elvisplantak/SynMachine/hardware/README.md

# Hardware design documentation

This directory is reserved for future mechanical drawings, CAD, wiring diagrams
and component documentation. No new design file or hardware capability is implied
by this placeholder. Current physical facts remain canonical in
[firmware/HARDWARE_CONFIRMATIONS.md](../firmware/HARDWARE_CONFIRMATIONS.md).
Any future hardware-design license will be selected explicitly and may differ
from the software license.
