elvisplantak/SynMachine/docs/LABFORGE_DEVELOPMENT_GOVERNANCE.md

# SynMachine Development Governance and Independent Review Workflow

This document is the authoritative and overriding source for the current
LabForge development workflow, agent roles, approval boundaries, and review
process. If it conflicts with older workflow instructions, this document takes
precedence. Other project documents remain useful as historical context and
technical information, but may contain outdated implementation status or
superseded workflow decisions.

## Roles

- Codex is the primary implementation agent and leads development.
- ChatGPT is the independent architectural, safety, protocol, recovery, and
  integration reviewer.
- The user owns product intent, unconfirmed physical facts, meaningful competing
  product choices, risky actions, and physical-execution authorization.

## Autonomous development scope

The user has granted Codex standing authorization to inspect, design,
implement, test, build, diagnose, self-review, update implementation-status
documentation, create feature branches, stage, create local commits, and push
Codex feature branches within the currently approved development phase.

Codex may autonomously complete all safe, non-blocked software milestones
inside that approved phase. It should not stop for review or approval after
every file edit, test, correction, commit, or other mechanical step.

User clarification on 2026-09-28: maximize independent progress and ask for
permission only when necessary under the actual approval boundaries below.
Codex decides whether to continue or request independent review; consolidate
review after substantial cohesive progress instead of reviewing each small
milestone. When review is warranted, provide the user a copy-paste handoff in
the conversation, not only a link to a document. This does not authorize physical
execution or other explicitly gated actions.

User clarification on 2026-09-30: independent reviewer suggestions are advisory,
not instructions to implement automatically. Prefer a coherent integrated slice
and consolidated review over repeated small checkpoints. Codex independently
chooses technically appropriate changes and remains responsible for delivery.

User clarification on 2026-10-01: use the independent reviewer much less often.
Continue safe implementation across small substeps and consolidate review at a
substantial integration or safety boundary, rather than after each checkpoint.

User clarification on 2026-10-03: while the reviewer is unavailable, continue the
approved software integration autonomously. Consolidate independent review at the
end of the complete connected task; no intermediate reviewer response is required.
Physical execution, production activation and main merges remain gated.

Before entering a materially different or riskier phase, Codex recommends the
next phase and obtains concise user approval. In particular, completing
no-motion protocol foundations does not authorize actuator implementation,
firmware upload, or physical execution.

## Normal workflow

Within the approved phase, Codex normally:

1. inspects canonical context, code, tests, and Git state;
2. protects unrelated work and isolates overlapping work in another branch or
   worktree when needed;
3. defines and implements the smallest cohesive slice;
4. adds or updates tests;
5. runs focused and complete relevant verification;
6. reviews the complete local diff and resource impact;
7. updates implementation-status documentation;
8. commits and pushes the verified feature branch; and
9. provides a concise checkpoint report for the user, plus an independent-
   reviewer handoff only when Codex identifies a meaningful review gate.

A dirty tree is not an automatic stop. Existing work must be inspected and
preserved. Stop only when safe isolation is impossible or changes overlap the
authorized scope in a way that cannot be resolved safely.

## Actions requiring explicit user approval

Codex must ask before:

- merging or directly modifying `main`;
- deleting branches or rewriting shared history;
- destructive or difficult-to-recover operations;
- creating or changing a PR when its publication or final scope needs a user
  decision;
- clearing, repairing, migrating, or provisioning EEPROM;
- uploading firmware or opening a Serial monitor against real hardware;
- homing or moving any physical actuator;
- running no-load, liquid, or other physical tests;
- selecting unconfirmed wiring, pins, switch contact mode, electrical polarity,
  motor/valve direction, angles, steps, calibration, or safe fluidic routes; or
- resolving a meaningful product or safety choice with competing alternatives.

Software authorization never implies physical authorization.

## Canonical sources and repository ownership

- `docs/LABFORGE_CONTEXT.md` is canonical for system-level context.
- `docs/LABFORGE_CURRENT_STATE.md` is canonical for the concise current development
  checkpoint.
- Firmware `firmware/HARDWARE_CONFIRMATIONS.md` is canonical for confirmed physical
  hardware facts.
- Firmware `firmware/docs/LABFORGE_SERIAL_PROTOCOL_V1.md` is canonical for software
  communication semantics.
- Current code and passing tests establish actual implementation state.

Frontend owns visualization and user interaction. Backend owns lifecycle,
planning, durable intent, route decisions, recovery policy, and orchestration.
Firmware owns pins, motor direction, stepping, homing, debounce, low-level
timeouts, and device execution. Arduino must not contain the complete Guided
Demo workflow. Frontend-disabled controls are not a safety boundary. Symbolic
backend routes do not authorize physical execution, and software completion is
not proof of physical movement.

## Physical and safety boundaries

- Never invent unconfirmed wiring, pins, polarity, direction, angle, step count,
  calibration, sensor capability, or safe physical behavior.
- `P1` and `P2` are syringe pumps, not inline pumps.
- Aspiration and dispense are separate operations.
- Pump homing can move fluid and requires a physically verified safe route.
- Topology, actuation, leak testing, calibration, and end-to-end execution are
  separate confirmation levels.

If a physical fact blocks one task, Codex asks the user a concrete question and
continues unrelated safe work where possible.

## Independent review checkpoints

Codex decides when a completed checkpoint should be sent to the independent
reviewer and tells the user explicitly. Review is not requested after every
commit, documentation correction, added unit test, mechanical refactor, or
review-follow-up fix. This keeps Codex as the development lead and avoids
turning independent review into day-to-day task management.

Meaningful independent review gates include framing/parsing/serialization,
EEPROM boot identity, handshake/session behavior, status queries, command
lifecycle and duplicate caching, first dispatch, first Service actuator,
homing/limit behavior, backend serial integration, fault injection, upload
readiness, first no-load test, first liquid-route test, and end-to-end Guided
Demo execution.

Reviews use focused evidence: relevant commits or diffs, specific source files,
test results, and build/resource metadata. Passing tests alone do not prove
physical readiness. Large review bundles and repeated review of mechanical
substeps are avoided.

At a meaningful gate, Codex prepares a short structured handoff containing:

- repository, branch, reviewed commit, and base commit;
- purpose and exact scope;
- what the user explicitly approved;
- intentionally unimplemented boundaries;
- focused verification and resource results; and
- a small set of concrete review questions.

The reviewer inspects the identified GitHub commit using that handoff. A broad
request to inspect the repository without a pinned commit and review focus is
not the normal workflow because it can lose approval context, review stale
work, or expand scope. Codex evaluates returned findings independently, accepts
technically sound findings, rejects findings based on missing or incorrect
context, and records any resulting checkpoint. Independent review never grants
physical authorization.

## Protected firmware recovery artifacts

Never access, search, list, diff, summarize, modify, or use anything under
`firmware/recovery/` or its preserved legacy counterpart
`~/Documents/labforge-firmware/recovery/` unless the user explicitly authorizes
that exact action. Recovery artifacts are not current production behavior.

## Reporting and continuity

Codex keeps reports concise: branch/HEAD, changed files, functional result,
tests/build/lint, relevant resource usage, `git diff --check`, final Git status,
limitations, and real decisions requiring user input.

`docs/LABFORGE_CURRENT_STATE.md` is updated at meaningful checkpoints so a new
session can determine what is complete, what is in progress, what comes next,
and which physical decisions remain unresolved. Detailed history remains in Git
and technical documents rather than being duplicated there.

Codex decides when the active conversation should move to a new session. Before
recommending that transition, Codex checks whether all information needed for
safe continuation is already preserved in the canonical documents, current
code, Git history, and pushed branch state. It updates
`docs/LABFORGE_CURRENT_STATE.md` or another canonical technical document only where
relevant information is missing.

If a separate handoff is useful, it is a concise delta only: current repository,
branch and HEAD; worktree state; newly completed work; the immediate next step;
remaining limitations; and unresolved user or physical decisions. It must not
repeat history, decisions, test evidence, or technical facts already recorded
in canonical documents or Git. If the existing sources are sufficient, Codex
creates no redundant handoff and instead identifies the documents and commits
the new session must read.

## Monorepo migration authorization — 2026-10-20

The user explicitly approved creating one repository and correcting commit
authorship through a verified import. Original repositories and verified backups
remain untouched. This does not authorize public visibility, selecting a license,
firmware upload or physical execution. Recovery access for this migration is
limited to unchanged import and integrity verification; ongoing access still
requires explicit action-specific authorization.
