elvisplantak/SynMachine/backend/docs/BROWSER_CHECK.md

# Guided Demo browser check with fake transports

This development-only launcher reuses the existing FastAPI application, owned
executor, adapter composition and test fixture Serial/DYNAMIXEL transports. It
adds no production endpoint, diagnostic layer or device configuration. Both fake
transport factories are hardwired; no live adapter is selected by a CLI flag.
Fixture route order, calibration, readiness and current context are not physical
facts. Real devices, original project databases and production activation are
outside this check.

## Start

From the active backend checkout, using its existing development virtualenv:

```bash
cd /home/elvis/Documents/labforge-backend-multiphase
env -u LABFORGE_ARDUINO_PORT -u LABFORGE_SF_BOTTOM_VALVE_PORT \
  /home/elvis/Documents/labforge-backend/.venv/bin/python -m tests.browser_check \
  --state-dir /tmp/labforge-browser-check --port 8000
```

The launcher rejects nonempty live-port environment settings before importing
`app.main` or creating state. The `env -u` command clears only this process's two
port settings. Importing the launcher itself is inert. It prints
`FAKE TRANSPORTS ONLY`, its state directory and PID. It runs one worker on
127.0.0.1 without automatic reload. An occupied port is an error; do not terminate
an unrelated server to make room.

In another terminal, start the existing UI:

```bash
cd /home/elvis/Documents/labforge-ui-multiphase
npm run dev -- --host 127.0.0.1 --port 5173 --strictPort
```

Open http://127.0.0.1:5173/ and select Open Guided Demo, then Connect to backend.
The existing Vite proxy targets 127.0.0.1:8000. Initial system initialization is
optional before a run and required for a first standalone flush.

## State, timing and restarts

The first launch provisions a new fake bundle in an empty state directory and
writes `browser-check.json` with its explicit fake-profile marker and database
identities. Restart reopens the same three files with those identities. It never
repairs, resets or migrates an existing directory. Unknown/nonempty directories,
missing files, changed profile markers and symlinks are rejected. A partially
created fixture is preserved; use a new directory for an independent scenario.
Do not delete/recreate state to bypass a retained owner during a restart check.

Waits use the existing real monotonic timer, making Pause/Resume/Stop observable.
Each fake Arduino command adds 0.15 seconds of artificial latency by default;
`--command-delay` may set 0..1 seconds. This is test pacing, not physical timing.
Serial/SF adapter sessions, journals and lifecycle remain the actual code paths.
The fake fixture is freshly supplied after restart; old commands are not replayed
or promoted to physical trust.

Ctrl+C requests orderly shutdown/Stop. For an actual process-death scenario,
deliberately stop only the identified fake launcher's process and restart using
the same state directory. Graceful shutdown and process death are separate tests.

## Browser scenarios

Use explicit nonzero SF mixing and fraction durations and a delay/reaction hold
long enough to click controls. Reaction duration in the UI is entered in minutes;
SF, settling, delay and fraction durations are seconds. All values are test data.

- Complete a run and verify COMPLETED/READY, backend event history and a second run.
- Pause/Resume a started delay or reaction wait; Stop while running or paused.
- After clean Stop verify ABORTED/FLUSH_REQUIRED, blocked new-run entry, then
  explicit per-attempt maintenance confirmations, successful flush and a new run.
- Attempt competing Service work while running; backend exclusion must reject it.
- Refresh the page or interrupt UI connectivity; read current backend state on
  return, without automatic resubmission of Start or other commands.
- Stop during flushing, restart the same fixture and verify explicit recovery
  followed by mandatory flushing before a new run.

To inject a transport error, stop the fake server and restart it with the same
command plus `--fault-command N`. The Nth fake Arduino COMMAND in that process
raises an injected transport error. It is not a retry or alternate transport.
After the error, restart without that flag using the same state directory.
Historical unknown outcome evidence must remain; recovery/flush must be deliberate.

If the backend restarts after recovery or clean Stop and before flushing,
FLUSH_REQUIRED and ownership persist, but the execution session continuity does
not. Repeat explicit recovery with fresh per-attempt confirmations, then flush
in that same process. A durable FLUSH_REQUIRED snapshot alone cannot authorize
commands. After successful flushing/release, READY and permission for a new run
persist across restart; the interrupted historical run remains FAULTED/ABORTED.

## Observed browser results — 2026-10-04

User-led localhost browser checks used the same marked temporary bundle throughout,
with real adapters over fake transports. Configuration: total 10 ml, B1 1.6 ml,
B2 2.4 ml, S 6 ml, B1 then B2, addition delay 5 s, reaction 1 min, SF mixing
10 s, settling 5 s, two fractions at 5 s each. These are hypothetical test values.

- Initialization reached READY; Start/Pause/Resume reached PAUSED during reaction
  hold and then COMPLETED/READY.
- A second run stopped during reaction hold reached ABORTED/FLUSH_REQUIRED.
  New run stayed blocked until deliberate flushing succeeded.
- `--fault-command 3` stopped the next run with retained ownership. Restart without
  injection produced FAULTED/RECOVERY_REQUIRED without a UI command or automatic
  continuation. Explicit recovery reached FLUSH_REQUIRED while new run stayed blocked.
- Restart between recovery and flushing preserved FLUSH_REQUIRED/ownership but
  required recovery again in the current process. Repeated recovery and mandatory
  flushing returned READY/released ownership.
- A further restart preserved READY/new-run permission; a new run then completed
  normally. User screenshots and read-only HTTP snapshots corroborated the results.
- Fresh maintenance confirmations were cleared after each submitted attempt.

This records the listed interactions only. Hard process death, Service contention,
Stop during flushing and page reload were not manually exercised in this session.
The launcher's automated tests verify environment
rejection, complete HTTP execution with wall-clock waits, persistence across
restart, failure/recovery/flush/new run, lost recovery continuity after restart,
durable release/new-run permission and refusal to reset/rebind foreign state.

## Optional fresh operator-input browser check — 2026-10-06

Append `--operator-confirmations` to the launch command to replace the automatic
fixture callback with the concrete UI declaration source. Both transport
factories remain hardwired fakes. Use a separate empty state directory such as
`/tmp/labforge-operator-browser-check` for an independent check, or retain the same
marked bundle when deliberately verifying restart. No old bundle is reset.

The launcher prints a new random `FAKE OPERATOR CREDENTIAL (this process only)`
locally once. Enter that credential in the new panel when initialization/Start
asks for current input; the configured identity is `browser-check operator`.
Each request lasts 120 seconds in this fake profile. Input is blank and consent
unchecked on each new request. Initialization and first Start need separate
confirmations. These are hypothetical fixture references only:

| UI field | Fake fixture value |
| --- | --- |
| P1/P2 raw position | 4100 for each |
| V1-V8 | 0 degrees for each |
| Reactor and SF mixers | Stopped |
| SF bottom valve | Closed |
| Column reference | HOME (0) |
| Manually aligned carousel | 40 |
| Evidence | An explicit note describing this new fake-only attempt |

Never enter these fixture values as observations of a physical machine. A
recovery request intentionally leaves pumps/valves/Column/SF unknown; supply only
fresh stopped-Reactor/manual carousel-40 input in that panel, along with the
existing per-attempt recovery readiness form. After recovery, deliberate mandatory
flushing must still reach durable READY/release before a new run.

Try missing/wrong credential, Cancel, Stop while waiting, expiration, partial
RUN references and an explicit retry. No actuator commands may precede valid
complete RUN input. Declaration acknowledgement is distinct from execution
completion. Reload/navigation performs reads only; it cannot submit input.
Restart rotates this fake credential, drops pending requests, preserves journal
and ownership, and requires fresh recovery input when continuity was lost.

Automated HTTP/source tests cover these boundaries, including shutdown during
initialization and old request/credential rejection after restart. UI fake-API
browser tests cover blank forms, credential clearing, per-request consent,
unknown recovery references, cancellation/expiration and read-only restoration.
These new interactions have not yet been manually checked by the user.

## Command-driven animation pacing

For visible fake-command animation, the existing `--command-delay 1` option can
slow each fake command to one second. The connected Guided Demo and Recipes
schematics then show aspiration and dispense separately, plus the protected
Column collection dwell. Shorter commands may fall between UI samples and are
never replayed or artificially extended to make their paths visible. Keep the
same marked state directory to preserve recipes and run evidence. This option
changes only fake test pacing and does not change actuator speed or production
configuration.
