elvisplantak/SynMachine/ui/docs/reviews/2026-10-03-backend-handoff.md

Please respond to the user in Croatian/BHS.

Please perform a consolidated independent review of the exact backend range below.

Repository: elvisplantak/labforge-backend
Branch: codex/recovery-reference-checks
Last accepted base: 3d9fab24f325f3a2da59d69215465e110acd3c33
Review HEAD: 9245e9e3f66716eb5dde17aaa3bd3b432f058e99
Remote branch was verified to match this HEAD on 2026-10-03.

Scope: 18 files, 2392 insertions and 5 deletions. Four cohesive checkpoints:
- 0ee2b83: read-only inspection of the explicitly identified ownership/execution/lifecycle databases.
- d5d1843: exclusive offline execution and explicit interruption reconciliation, including interrupted PAUSED waits.
- d3274ef: fresh non-actuating Arduino/SF observations using existing adapters with fake transports in tests.
- 9245e9e: process-local operator reference attestations bound to the interrupted run, retained owner and current controller session.

Implementation:
- Offline runtime holds advisory locks on all three existing bundle files and uses the existing owned executor for all ten fresh fake demo phases.
- Restart never adopts a persisted run. Reconciliation retains the existing owner or commits a new BLOCKED reservation before the separate lifecycle transaction. Command journals/plans remain unchanged; no lease is reconstructed or released.
- Explicit paused-wait reconciliation is opt-in; the legacy default remains unchanged. Supported started PAUSED waits become FAULTED/RECOVERY_REQUIRED, without reconstructing elapsed time or resuming execution.
- Fresh observation brackets the read-only SF register sample with correlated trusted-IDLE Arduino queries and checks required capabilities and connection generation. SF inspection writes no registers and does not correct position/torque.
- Reference checks require a reconciled interruption and retained owner. Confirmations/reporting sample again; stale/copied/foreign challenges, restart, reconnect, observation failure or tracked database changes invalidate use. Operator/evidence strings are supplied attestations, not authenticated identity or sensor proof.
- Even complete attestations never authorize release, change lifecycle state, or permit a physical run.

Please focus on:
1. Exclusion and crash boundaries: competing/overlapping runtimes, close/reentrancy, owner retention before lifecycle commit, retries after either commit and no accidental restart/resend path.
2. PAUSED reconciliation invariants, atomic run/machine updates, rollback and isolation from default legacy startup behavior.
3. Fresh observation/session correlation, adapter cleanup failures, SF sampling limitations and assurance that no new observation path moves hardware.
4. Challenge freshness, reference invalidation, SQLite data_version/total_changes handling and resistance to stale summaries/attestations being mistaken for current trust.
5. Any actual correctness gaps, bypasses or misleading claims at the boundary between software reconciliation, operator statements and physical readiness.

Important limits (not claimed complete):
- Advisory locks protect this explicit offline composition only, not historical direct assemblies, arbitrary database writers or all production processes.
- Cross-database commits and observations are not atomic.
- SF observations use short-lived sessions; no durable physical/session trust is established.
- No physical recovery/flush executor, durable owner release, reusable new-run startup, approved live route switching, live SF OPEN/Stop integration or production transport/API/UI activation was added.
- No schema migration, firmware change, physical test or merge to main occurred. All new hardware-adapter tests use injected fake transports.

Verification:
- Fresh handoff verification: 116 focused tests passed; Ruff and git diff --check passed.
- Fresh full suite on 2026-10-03: 1668 tests passed in 59.47 s at the unchanged review HEAD.
- Do not treat local test results as independently rerun unless you actually rerun them.

Relevant backend documents:
- docs/OWNED_STARTUP_INSPECTION.md
- docs/OWNED_OFFLINE_RECONCILIATION.md
- docs/FRESH_HARDWARE_OBSERVATIONS.md
- docs/RECOVERY_REFERENCE_CHECKS.md

Primary code: app/hardware/owned_startup_inspection.py, owned_offline_runtime.py,
recovery_reference_checks.py, fresh_hardware_observations.py, sequence_ownership.py,
arduino_serial.py, sf_bottom_valve.py; app/demo/startup_execution_reconciliation.py;
app/persistence/sqlite_store.py. Tests correspond to the four new checkpoints.

The user authorized this consolidated review and continued software development.
The next approved task (recovery + mandatory flush + safe release/new-run path,
real-adapter preparation via fake transports) was only inspected before a credit
interruption; it is not implemented by this HEAD. Do not review it as completed.
Please report Critical/High/Medium/Low findings with concrete locations and impact,
separating actual defects from future production gates. Review does not authorize
physical execution, production activation, firmware upload, migration or main merge.
