elvisplantak/SynMachine/docs/README.md

# SynMachine documentation

- [Current state](LABFORGE_CURRENT_STATE.md)
- [System context](LABFORGE_CONTEXT.md)
- [Development governance](LABFORGE_DEVELOPMENT_GOVERNANCE.md)
- [Repository migration](MIGRATION.md)
- [Historical commit and branch maps](history/README.md)
- [Publication and license status](PUBLICATION.md)
- [Publication verification](PUBLICATION_VERIFICATION.md)
- [Third-party dependency licenses](THIRD_PARTY_NOTICES.md)
- [Recipe editing guide](../ui/docs/UVP_USER_GUIDE.md)
- [Explicit live Recipes preparation](../backend/docs/LIVE_RECIPES.md)
- [Confirmed physical facts](../firmware/HARDWARE_CONFIRMATIONS.md)
- [Serial protocol](../firmware/docs/LABFORGE_SERIAL_PROTOCOL_V1.md)

Older dated reviews and commissioning records remain in their component `docs/`
directories. Their original names and reviewed commit IDs are historical evidence;
use the maps when locating corresponding imported commits in this repository.
