elvisplantak/SynMachine/docs/PUBLICATION.md

# Publication and licensing status

## Current checkpoint — 2026-10-20

The owner approved the English root README, supplied prototype photograph and
Apache-2.0 license, then authorized the final preparation and integration into
main. The README describes the colored-liquid mechatronic prototype, existing
silicone/medical-plastic parts and planned PTFE/glass material upgrades. The
supplied photograph is included unchanged near the top of the README.

The owner confirmed that the old code is their own. The root LICENSE grants
Apache-2.0 for original project software and accompanying documentation; NOTICE
records attribution. Dependencies retain upstream terms, documented in
[THIRD_PARTY_NOTICES.md](THIRD_PARTY_NOTICES.md). Future hardware design files and
redistributed binary bundles need their applicable licensing terms recorded.

The owner confirmed that the recovery archive should remain available when the
repository is made public. This resolves the separate recovery publication
question. No new access to protected recovery content was performed in this
follow-up; previous audit and unchanged migration evidence remain recorded.
Historical review records are preserved.

The README now acknowledges inspiration from Professor Lee Cronin and the Cronin
Group at the University of Glasgow, with a link to the group's official site.
The project is described as independent. On 2026-10-20 the owner explicitly
authorized public visibility and `elvisplantak/SynMachine` was made public.
Anonymous requests confirmed access to the GitHub repository page/API, README,
LICENSE and prototype photograph. The public raw files matched the local copies.
The default branch remains main and GitHub recognizes Apache-2.0.

Final verification and its limits are recorded in
[PUBLICATION_VERIFICATION.md](PUBLICATION_VERIFICATION.md). GitHub description
and topics are configured. No Actions/release/issue/comment content required
cleanup; Wiki and Pages are disabled. Original repositories remain private and
preserved. Additional photos or video can be added later.
