elvisplantak/SynMachine/backend/docs/PUBLIC_RELEASE_PREPARATION.md

> Historical pre-migration preparation document. Current publication state is in
> [../../docs/PUBLICATION.md](../../docs/PUBLICATION.md) and the current project
> description is in [../../README.md](../../README.md).

# SynMachine public-release preparation — 2026-10-19

The coordinated audit is recorded in the sibling UI repository at
`docs/PUBLIC_RELEASE_PREPARATION.md` on `codex/public-release-preparation`.
This repository adds local credential/runtime ignore rules and a proposed README
in `docs/PUBLIC_README_DRAFT.md`; the root README and project-license choice await
agreement. Repository visibility, default branch and history remain unchanged.

The existing live profile, operator credential, persistent databases and command
execution are unchanged. Untracked local runtime databases were not published.
