elvisplantak/SynMachine/firmware/docs/commissioning/2026-10-11/README.md

# SF mixer detached-wire recheck — 2026-10-11

User found one motor wire detached from its joint after boot96 twitching/buzzing.
The user explicitly requested a new isolated test and required notice before
power ON. Preparation was completed with motor power OFF: unchanged approved
runner (only evidence date changed), 44 fake-only/ownership checks passed, USB
port unoccupied. Host then requested power ON and fresh empty-SF/free-element/
secured-connection readiness; user confirmed ready. No port was opened beforehand.

Authorized scope: SF_MIXER_SET_STATE false -> true -> wait 3 s -> false.
Existing STEP D6/DIR D7, DIR=LOW, 500 pulses/s unchanged. No firmware upload,
other actuator command, reconnect/retry or production activation. Existing Serial,
durable executor, ownership and required STOP followup reused; RUN_BLOCK gate.

Boot98: all 3 durable commands and 2 owned sequences COMPLETED, timed wait 3 s,
owner idle, exit0, connection closed. User confirmed normal physical rotation
and stop, without twitching or unpleasant buzzing. This isolated dry SF start/
stop check is accepted. Detached wire is a user observation; no electrical
measurement or general failure diagnosis. Motor power last confirmed ON.

Bundle sf-mixer-recheck-805a29e9-2f84-4184-a736-568e0faec4a9/ contains unchanged
raw events.jsonl, commands.sql, owner.sql and result-verification.json.
SQLite originals retained locally/ignored. Runner/fake-check snapshots adjacent.
Boot96 failure and boot94 corrected acceptance remain unchanged. This test does
not retroactively establish physical SF mixing in boot94, wet mixing performance,
measured RPM/torque or complete wet-demo acceptance. No further motion queued.
