elvisplantak/SynMachine/(commit log)

2026-07-17 Document confirmed P2 pump orientation
2026-07-18 Add pump commissioning draft
2026-07-20 Replace pump action phases with transfer phases
2026-07-20 Add syringe pump calibration models
2026-07-20 Add shared operation models and P1 reagent plans
2026-07-22 Document confirmed LabForge v1 tubing topology
2026-08-02 Confirm column bottom valve pin assignments
2026-08-02 Add Arduino EEPROM boot identity bootstrap
2026-08-04 Prepare safe V7 V8 pin discovery
2026-08-10 Harden P1 homing and abort behavior
2026-08-10 Allow wider P1 HOME switch release
2026-08-11 Integrate P2 pump runtime
2026-08-11 Integrate V1-V8 valve runtime
2026-08-11 Record accepted V1-V8 demo homing assumption
2026-08-12 Integrate column bottom valve runtime
2026-08-12 Integrate SF bottom valve Dynamixel adapter
2026-08-12 Expose SF bottom valve service runtime
2026-08-12 Connect SF bottom valve service UI
2026-08-12 Remove SF valve confirmation popup
2026-08-12 Record SF valve UI physical validation
2026-08-12 Add Arduino serial transport adapter
2026-08-12 Persist Arduino command intent before dispatch
2026-08-12 Expose durable Arduino pump service commands
2026-08-12 Connect P1 P2 service pump controls
2026-08-12 Make Arduino journal thread safe
2026-08-12 Record end-to-end pump service validation
2026-08-12 Record physical pump service checkpoint
2026-08-12 Confirm UI driven pump service test
2026-08-12 Confirm UI driven pump service validation
2026-08-13 Add column valve service command API
2026-08-13 Add column valve service controls
2026-08-13 Serialize Arduino command transactions
2026-08-13 Guard concurrent Arduino service commands
2026-08-13 Record valve service follow-up tests
2026-08-15 Harden Arduino service UI reporting
2026-08-15 Extend Arduino command timeout for column homing
2026-08-15 Record column homing timeout correction
2026-08-15 Add conservative margin for column homing
2026-08-15 Recalibrate and instrument column valve
2026-08-15 Trace column homing progress
2026-08-15 Record column calibration diagnostics
2026-08-15 Record powered column home diagnosis
2026-08-16 Harden column home filtering
2026-08-16 Record demo pump calibration assumption
2026-08-16 Record demo pump volume mapping
2026-08-16 Show enabled Service buttons distinctly
2026-08-16 Confirm pump HOME at final allowed pulse
2026-09-28 Extend P1 simulation to reagent phases and exercise action-level faults
2026-09-28 Record P1 reagent progress and consolidated review preference
2026-09-29 Record resolved motor fault and pending recommissioning
2026-09-29 Record V7 V8 repair and powered identification tests
2026-09-29 Correct V7 V8 wiring and confirm production homing regression
2026-09-30 Add durable shared ownership for explicit Arduino SF Service composition
2026-09-30 Integrate owned collection timers and retained SF mixing lifecycle
2026-10-01 Compose exclusive offline execution and interruption reconciliation
2026-10-01 Add fresh non-actuating Arduino and SF observations
2026-10-01 Bind recovery reference attestations to current run and session
2026-10-03 Track both bracketing status request IDs for reference freshness
2026-10-06 Prepare adapter configuration and session-bound current state
2026-10-06 Record adapter current-context preparation checkpoint
2026-10-06 Record accepted adapter current-context review
2026-10-06 Record operator current-input checkpoint and review scope
2026-10-06 Record accepted operator current-input review
2026-10-06 Document nominal demo pump range and route switching inventory
2026-10-06 Record user-selected nominal demo pump endpoints
2026-10-06 Record nominal demo pump decision and route inventory checkpoint
2026-10-06 Document concrete valve switching cases for demo confirmation
2026-10-06 Record confirmed valve break-before-make behavior
2026-10-06 Record valve switching proposal and pending procedure confirmation
2026-10-06 Record user-approved demo route orders and staged machine check plan
2026-10-06 Record approved demo valve destination orders
2026-10-07 Record partial dry check and slower valve motion request
2026-10-09 Slow route valve motion for supervised dry checks
2026-10-09 Record slower valve firmware readiness checkpoint
2026-10-09 Record verified slower valve firmware upload
2026-10-09 Record installed slower valve firmware checkpoint
2026-10-09 Record grouped dry P1 and P2 valve checks
2026-10-09 Record grouped dry valve commissioning checkpoint
2026-10-09 Record halted dry pump commissioning checkpoint
2026-10-09 Wait motionless for late pump HOME signal at search limit
2026-10-09 Record verified final pump HOME signal wait preparation
2026-10-09 Record verified pump HOME wait firmware upload
2026-10-09 Record pump HOME wait upload checkpoint
2026-10-10 Record failed SF mixer cable-repair recheck and correct dry acceptance
2026-10-11 Record accepted SF mixer recheck after detached-wire repair
2026-10-11 Expose scoped command-flow activity for demo and recipe runs
2026-10-11 Animate current commanded routes in Guided Demo and Recipes
2026-10-11 Pin command-flow animation review checkpoint
2026-10-11 Record independent command-flow animation acceptance
2026-10-11 Record user observation of Guided Demo flow animation
2026-10-19 Prepare explicit live Recipes execution with attributed current input
2026-10-19 Use SynMachine in display titles and current documentation
2026-10-20 Add Apache 2.0 license and introduce SynMachine with prototype photo
